adan2013/DIY-Arduino-Dashboard/graphics/faces/gauge faces v4 without controls.pdf

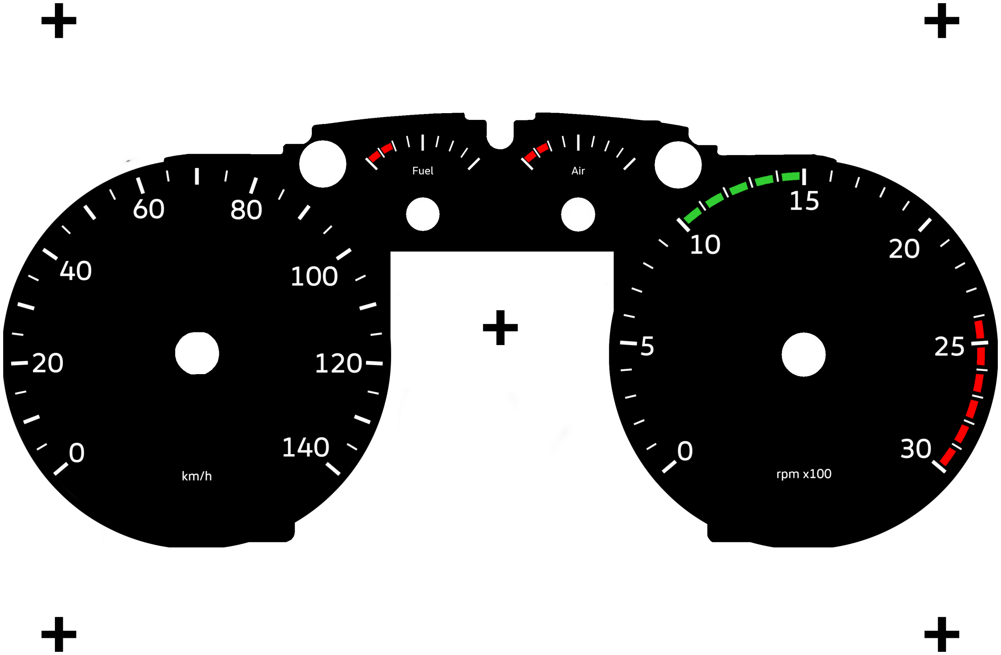
[picture p7: page 1]
