adan2013/DIY-Arduino-Dashboard/graphics/faces/gauge faces v4 with controls.pdf

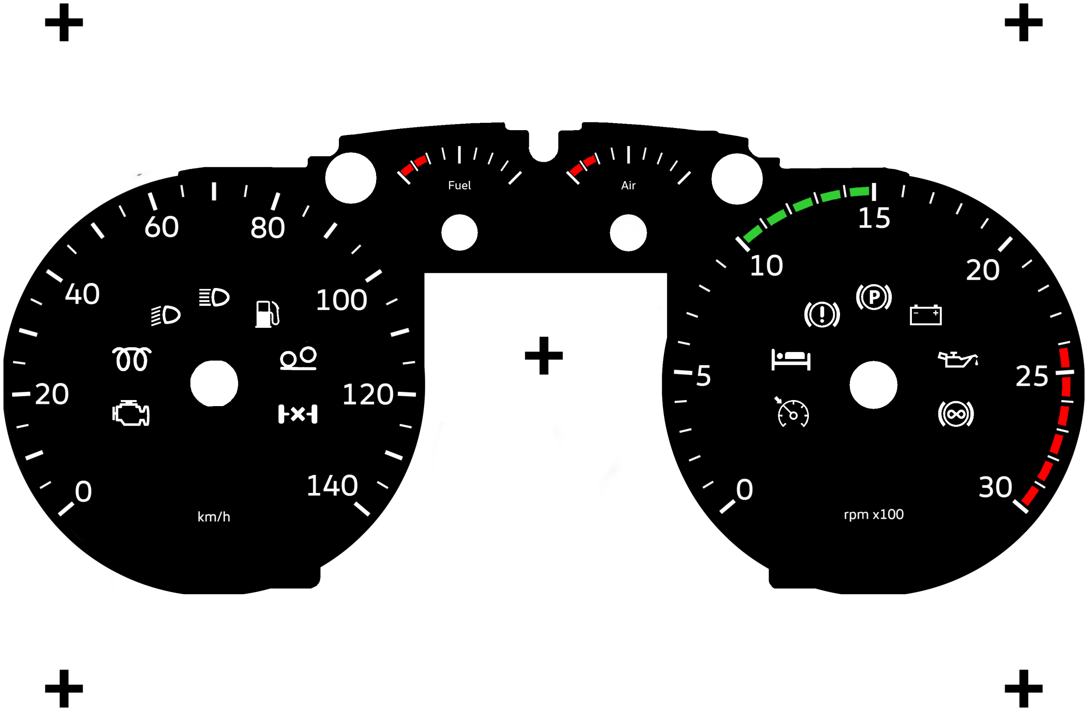
[picture p8: page 1]
