adan2013/DIY-Arduino-Dashboard/graphics/faces/gauge faces v3 bottom a4.pdf

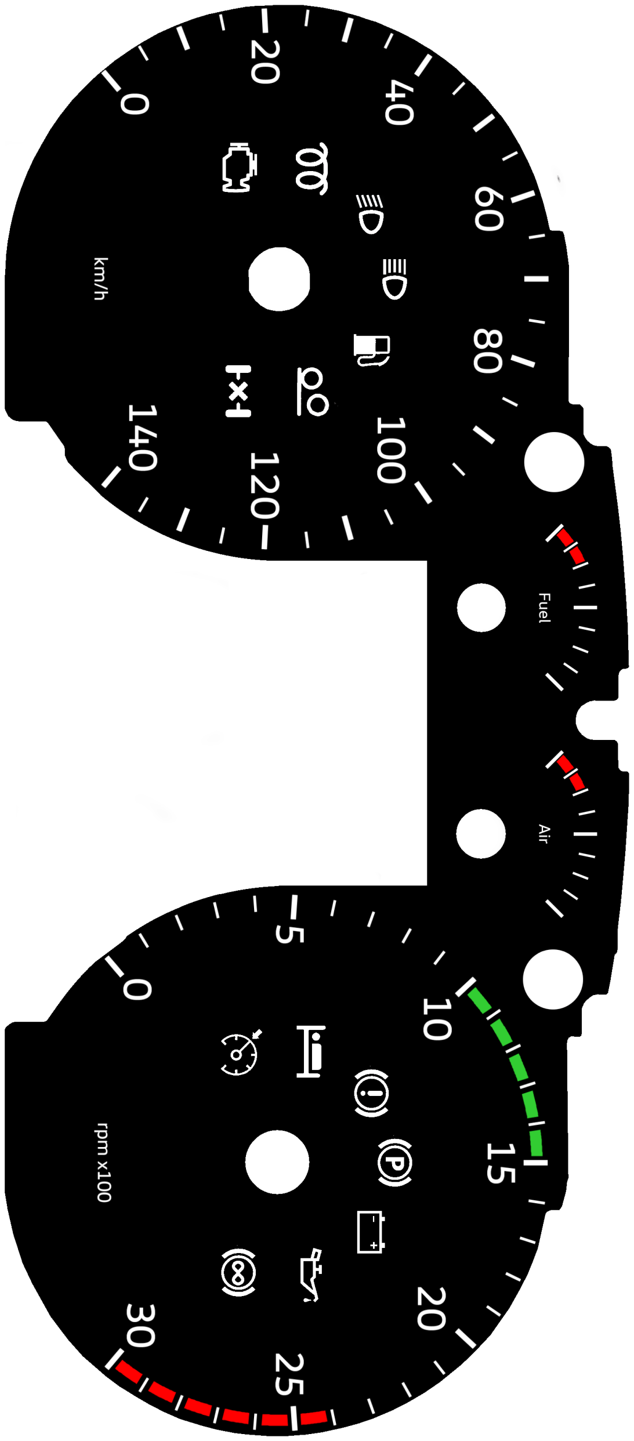
[picture p9: page 1]
