adan2013/DIY-Arduino-Dashboard/graphics/faces/gauge faces v3 top a4.pdf

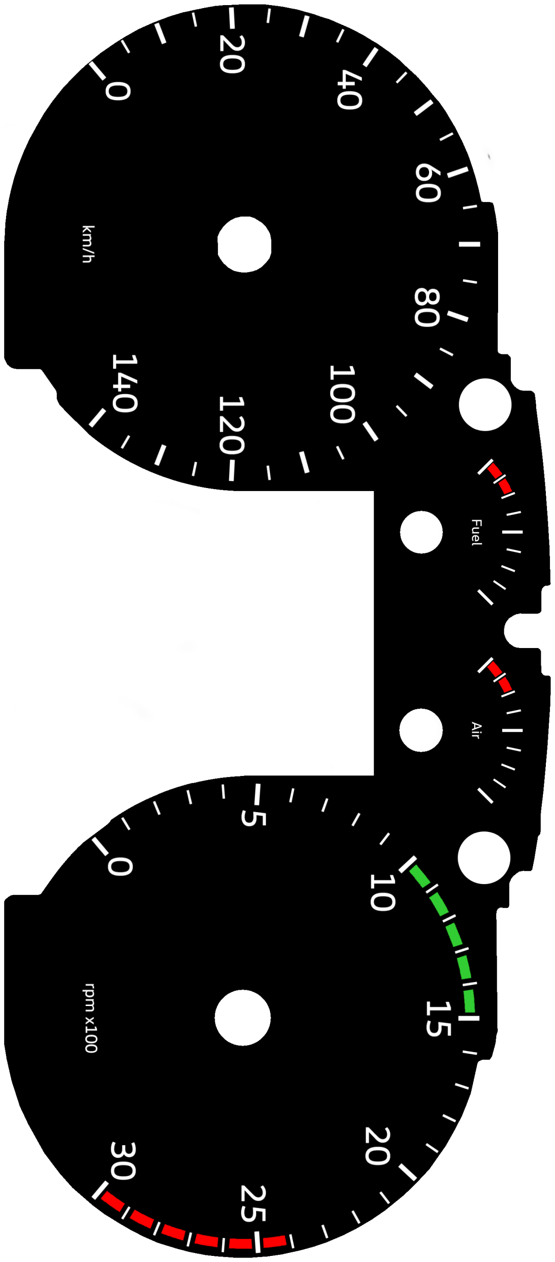
[picture p10: page 1]
