adan2013/DIY-Arduino-Dashboard/graphics/faces/gauge faces neg border a4.pdf

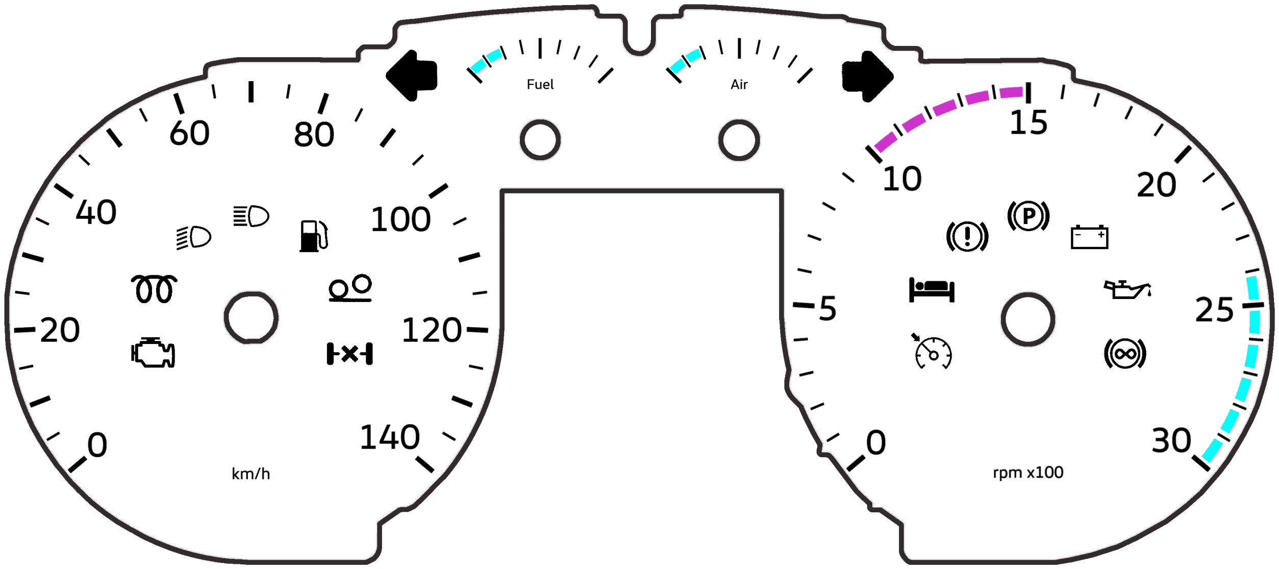
[picture p11: page 1]
