adan2013/DIY-Arduino-Dashboard/graphics/faces/gauge faces neg.png

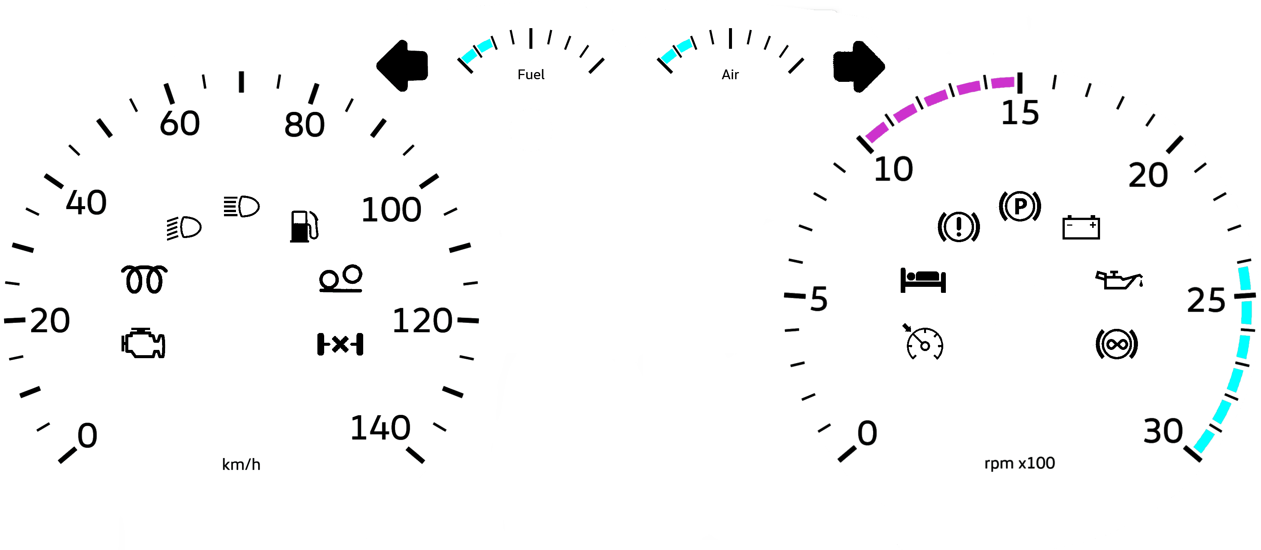
graphics/faces/gauge faces neg.png
