adan2013/DIY-Arduino-Dashboard/graphics/faces/gauge faces v2.png

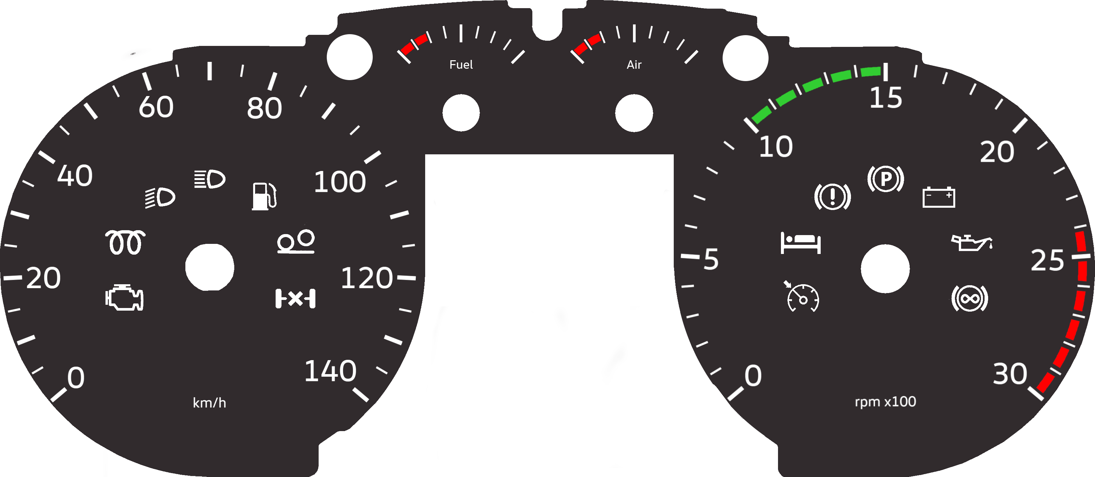
graphics/faces/gauge faces v2.png
