adan2013/DIY-Arduino-Dashboard/graphics/faces/original scan.jpg

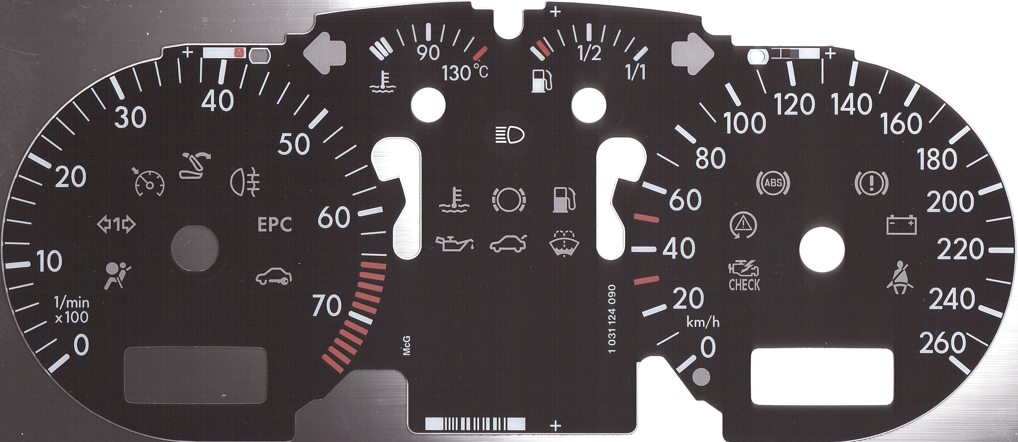
graphics/faces/original scan.jpg
