adan2013/DIY-Arduino-Dashboard/graphics/front/front.png

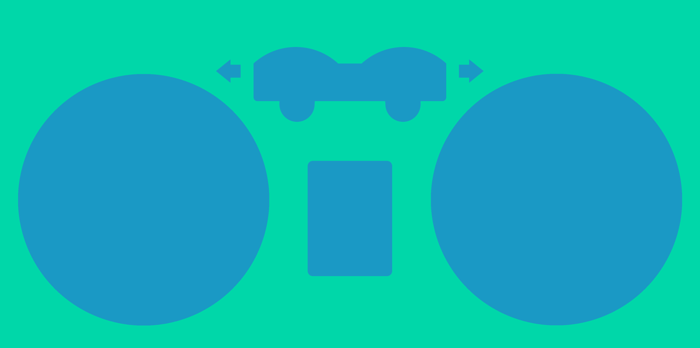
graphics/front/front.png
