adan2013/DIY-Arduino-Dashboard/graphics/front/original_scan.jpg

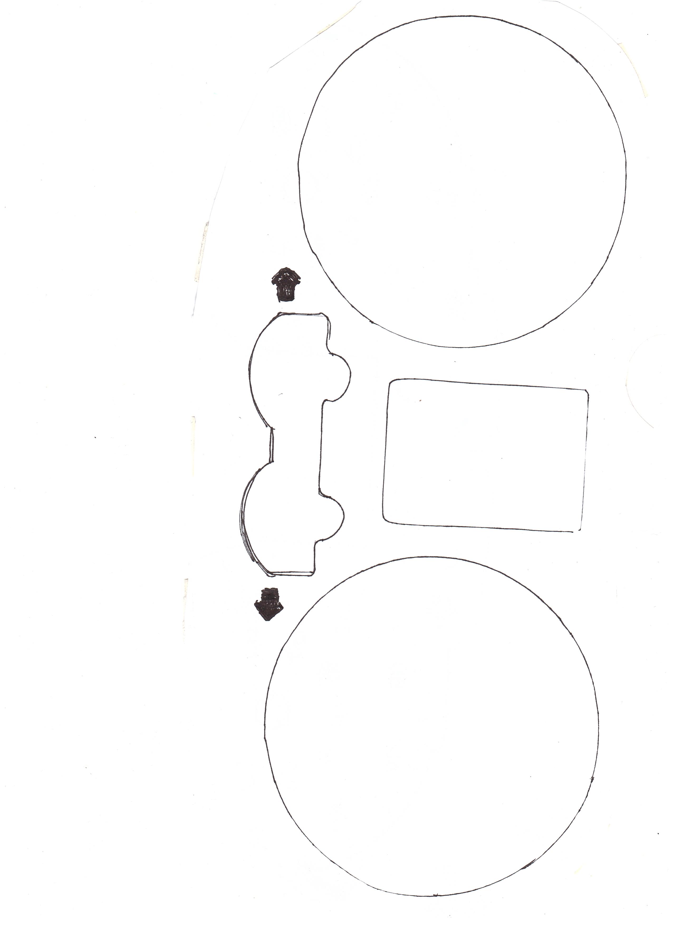
graphics/front/original_scan.jpg
