adan2013/DIY-Arduino-Dashboard/graphics/gauge generator projects/air.png

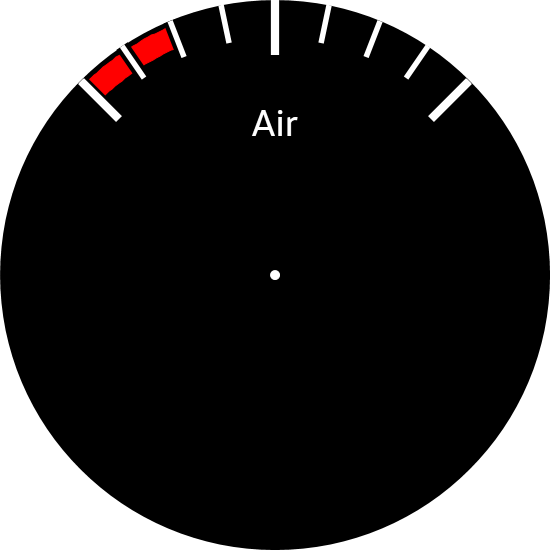
graphics/gauge generator projects/air.png
