adan2013/DIY-Arduino-Dashboard/graphics/gauge generator projects/engine.png

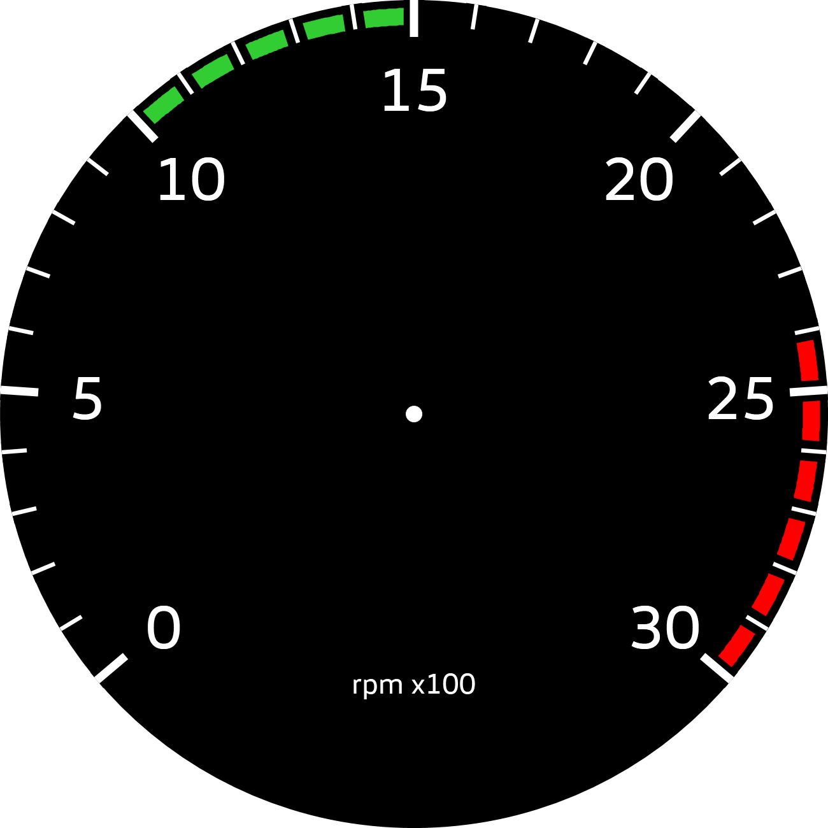
graphics/gauge generator projects/engine.png
