adan2013/DIY-Arduino-Dashboard/graphics/gauge generator projects/speed.png

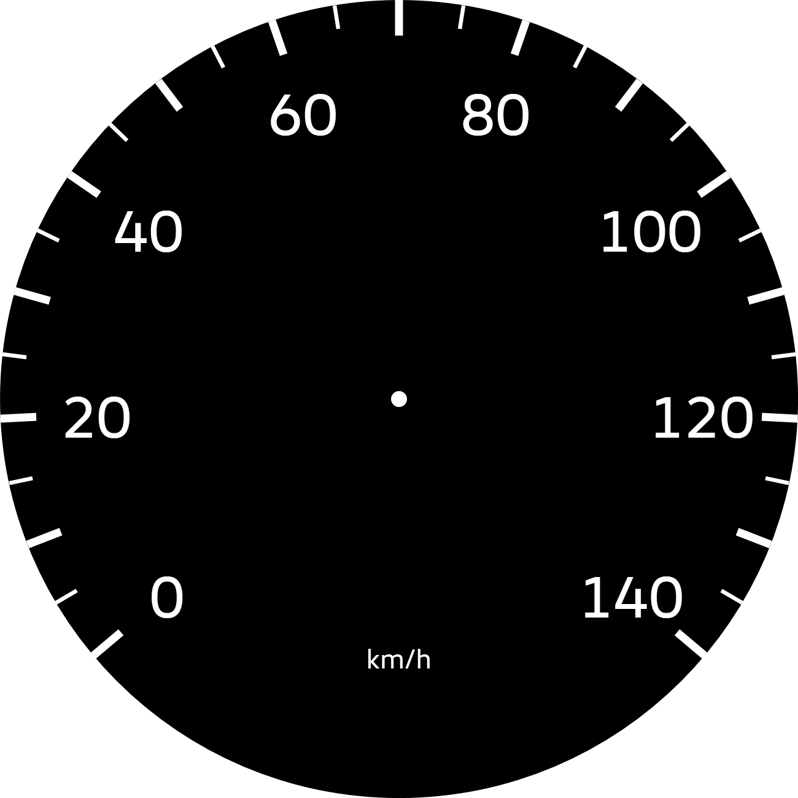
graphics/gauge generator projects/speed.png
