adan2013/DIY-Arduino-Dashboard/graphics/initial images/mercedes_big.jpg

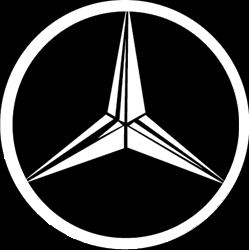
graphics/initial images/mercedes_big.jpg
