adan2013/DIY-Arduino-Dashboard/schema/arduino_schema.jpg

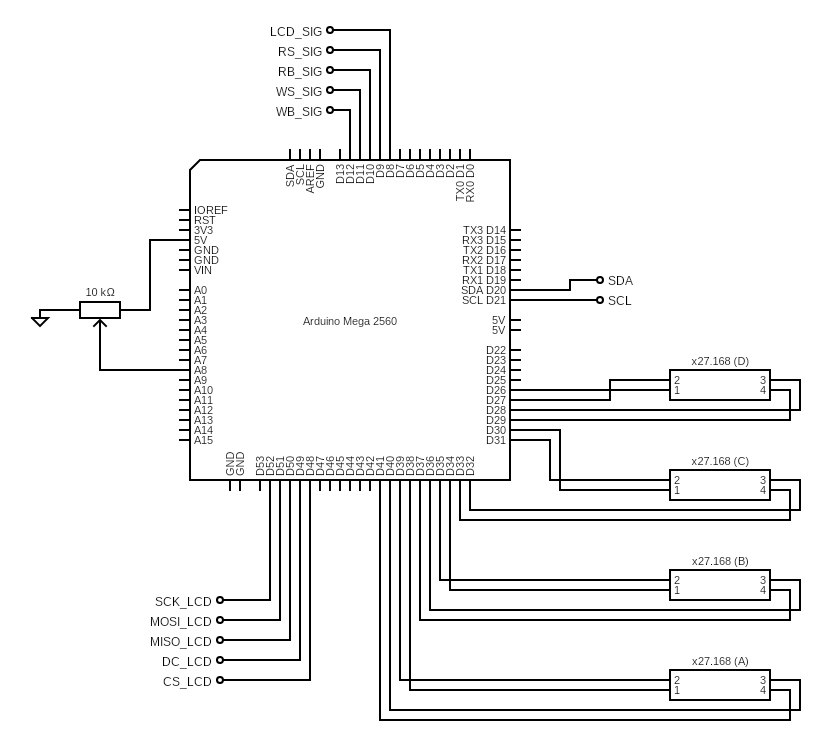
schema/arduino_schema.jpg
