adan2013/DIY-Arduino-Dashboard/schema/backlight_schema.jpg

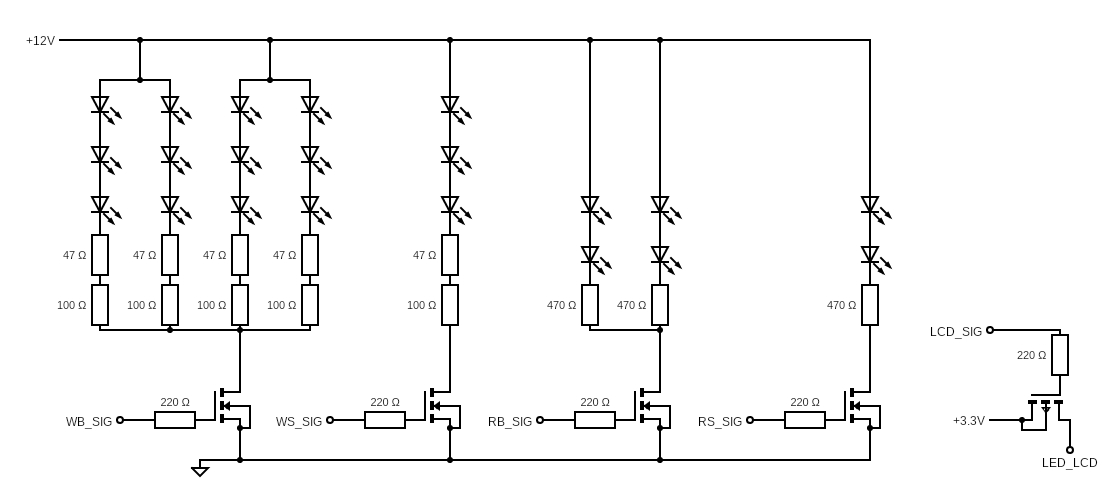
schema/backlight_schema.jpg
