adan2013/DIY-Arduino-Dashboard/schema/lcd_schema.jpg

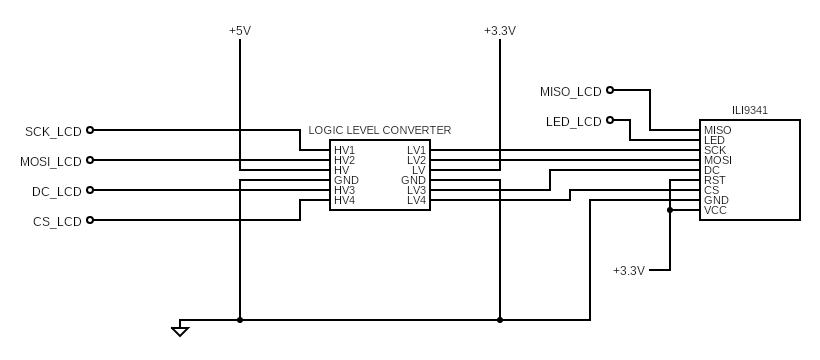
schema/lcd_schema.jpg
