adan2013/DIY-Arduino-Dashboard/schema/led_schema.jpg

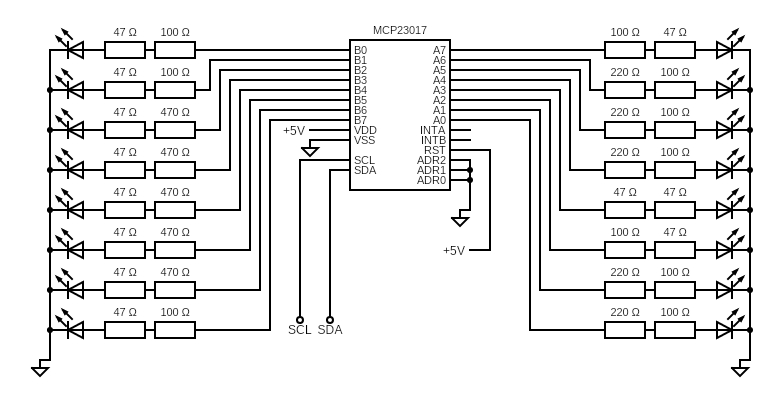
schema/led_schema.jpg
