adan2013/DIY-Arduino-Dashboard/graphics/front/front test v2.pdf

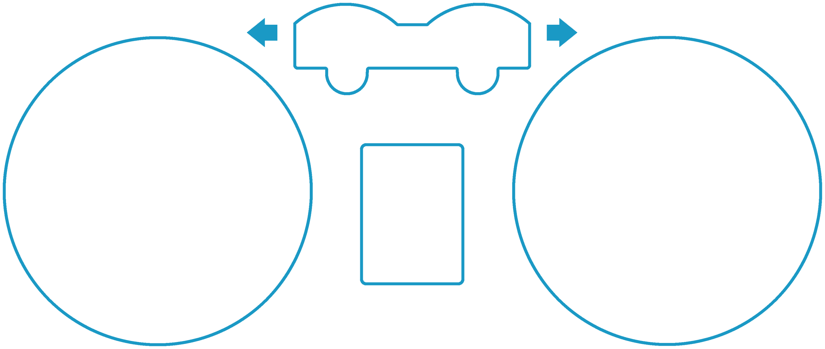
[picture p25: page 1]
