adan2013/DIY-Arduino-Dashboard/graphics/front/front test v1.pdf

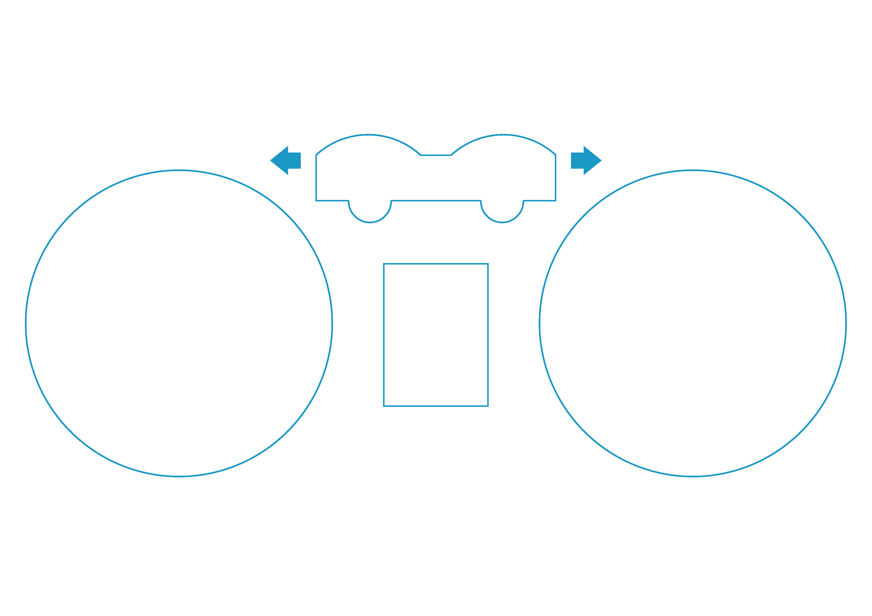
[picture p26: page 1]
