adan2013/DIY-Arduino-Dashboard/graphics/front/front test v1.png

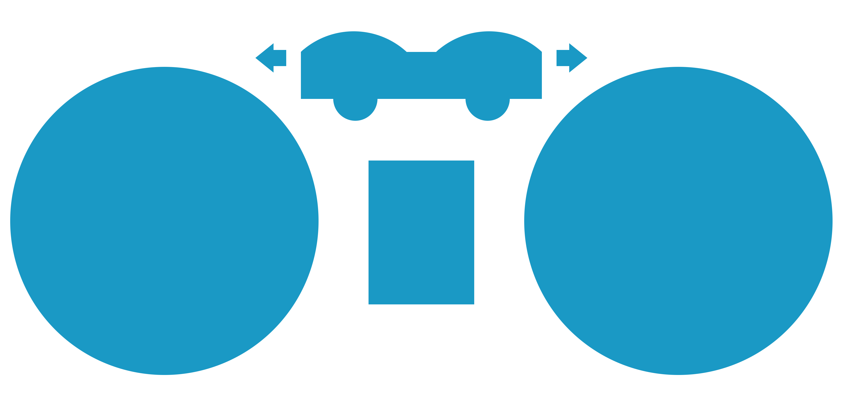
graphics/front/front test v1.png
