adan2013/DIY-Arduino-Dashboard/Arduino/ArduinoTelemetryReceiver/InitialImages.ino

// 'daf', 130x30px
const unsigned char dafImage [] PROGMEM = {
  0x00, 0x00, 0x00, 0x00, 0x00, 0x00, 0x00, 0x00, 0x00, 0x00, 0x00, 0x00, 0x00, 0x00, 0x00, 0x00, 
  0x00, 0x00, 0x00, 0x00, 0x00, 0x00, 0x00, 0x00, 0x00, 0x00, 0x00, 0x00, 0x00, 0x00, 0x00, 0x00, 
  0x00, 0x00, 0x00, 0x00, 0x00, 0x00, 0x00, 0x00, 0x00, 0x00, 0x00, 0x00, 0x00, 0x00, 0x00, 0x00, 
  0x00, 0x00, 0x00, 0xff, 0xff, 0xff, 0xfc, 0x00, 0x00, 0x03, 0xff, 0xff, 0xe0, 0x00, 0x1f, 0xff, 
  0xff, 0xff, 0xff, 0xc0, 0xff, 0xff, 0xff, 0xff, 0xc0, 0x00, 0x07, 0xff, 0xff, 0xf0, 0x00, 0x1f, 
  0xff, 0xff, 0xff, 0xff, 0xc0, 0xff, 0xff, 0xff, 0xff, 0xf0, 0x00, 0x07, 0xff, 0xff, 0xf8, 0x00, 
  0x1f, 0xff, 0xff, 0xff, 0xff, 0xc0, 0xff, 0xff, 0xff, 0xff, 0xfc, 0x00, 0x0f, 0xff, 0xff, 0xf8, 
  0x00, 0x1f, 0xff, 0xff, 0xff, 0xff, 0xc0, 0xff, 0xff, 0xff, 0xff, 0xfe, 0x00, 0x1f, 0xff, 0xff, 
  0xfc, 0x00, 0x1f, 0xff, 0xff, 0xff, 0xff, 0xc0, 0xff, 0xff, 0xff, 0xff, 0xff, 0x00, 0x1f, 0xff, 
  0xff, 0xfe, 0x00, 0x1f, 0xff, 0xff, 0xff, 0xff, 0xc0, 0xff, 0xff, 0xff, 0xff, 0xff, 0x00, 0x3f, 
  0xff, 0xff, 0xfe, 0x00, 0x1f, 0xff, 0xff, 0xff, 0xff, 0xc0, 0xff, 0xfe, 0x01, 0xff, 0xff, 0x80, 
  0x3f, 0xff, 0xff, 0xff, 0x00, 0x1f, 0xff, 0xe0, 0x00, 0x00, 0x00, 0xff, 0xfe, 0x00, 0x7f, 0xff, 
  0x80, 0x7f, 0xff, 0x3f, 0xff, 0x00, 0x1f, 0xff, 0xe0, 0x00, 0x00, 0x00, 0xff, 0xfe, 0x00, 0x3f, 
  0xff, 0xc0, 0x7f, 0xff, 0x3f, 0xff, 0x80, 0x1f, 0xff, 0xe0, 0x00, 0x00, 0x00, 0xff, 0xfe, 0x00, 
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
  0xff, 0xff, 0xff, 0xc0, 0xff, 0xff, 0xff, 0xff, 0xff, 0xff, 0xff, 0xff, 0xff, 0xff, 0xff, 0xc0, 
  0xff, 0xff, 0xff, 0xff, 0xff, 0xff, 0xff, 0xff, 0xff, 0xff, 0xff, 0xc0, 0x7f, 0xf8, 0x00, 0x00, 
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
};
