adan2013/DIY-Arduino-Dashboard/tests/led_backlight_controller_test/led_backlight_controller_test.ino

#include <Wire.h>
#include <Adafruit_MCP23017.h>

Adafruit_MCP23017 mcp;

void setup() {
  //LED
  mcp.begin();
  for(int i = 0; i < 16; i++) {
    mcp.pinMode(i, OUTPUT);
    mcp.digitalWrite(i, LOW);
  }
  //BACKLIGHT
  pinMode(8, OUTPUT);
  pinMode(9, OUTPUT);
  pinMode(10, OUTPUT);
  pinMode(11, OUTPUT);
  digitalWrite(8, LOW);
  digitalWrite(9, LOW);
  digitalWrite(10, LOW);
  digitalWrite(11, LOW);
}

void loop() {
  for(int i = 0; i < 16; i++) {
    //LED
    int prev = i - 1;
    if(prev < 0) prev = 15;
    mcp.digitalWrite(prev, LOW);
    mcp.digitalWrite(i, HIGH);
    //BACKLIGHT
    switch(i) {
      case 0:
      case 1:
      case 2:
        digitalWrite(8, HIGH);
        digitalWrite(9, LOW);
        digitalWrite(10, LOW);
        digitalWrite(11, LOW);
        break;
      case 3:
      case 4:
      case 5:
        digitalWrite(8, HIGH);
        digitalWrite(9, HIGH);
        digitalWrite(10, LOW);
        digitalWrite(11, LOW);
        break;
      case 6:
      case 7:
      case 8:
        digitalWrite(8, HIGH);
        digitalWrite(9, HIGH);
        digitalWrite(10, HIGH);
        digitalWrite(11, LOW);
        break;
      case 9:
      case 10:
      case 11:
      case 12:
        digitalWrite(8, HIGH);
        digitalWrite(9, HIGH);
        digitalWrite(10, HIGH);
        digitalWrite(11, HIGH);
        break;
      case 13:
      case 14:
      case 15:
        digitalWrite(8, LOW);
        digitalWrite(9, LOW);
        digitalWrite(10, LOW);
        digitalWrite(11, LOW);
        break;
    }
    delay(500);
  }
}
