adan2013/DIY-Arduino-Dashboard/(commit log)

2020-04-22 mcp test & i2c scan
2020-06-08 led controller test code
2020-06-16 backlight pwm test code
2020-07-06 new screen & sound control buttons
2020-07-11 first version of arduino code
2020-07-21 final front 4mm version
2020-12-30 lcd test with hardware spi
2021-01-01 motor control improvements WIP
2021-01-01 arduino serial reader - first version
2021-01-03 hardware blinking leds
2021-01-04 trailer screen v2 fix
    [ScreenPrint.ino, ScreenUpdate.ino]
2021-01-05 MOTOR_LATENCY deleted
2021-01-12 welcome signal & led animation
2021-02-13 sound and notification fix
    [ScreenTools.ino]
2021-02-14 final fixs, deleted current speed from assistant fields, refresh data optimization
    [ScreenTools.ino, ScreenUpdate.ino]
2021-02-14 final fixs, deleted current speed from assistant fields, deleted trailer name, refresh data optimizationg
    [ScreenTools.ino, ScreenUpdate.ino]
2021-04-23 gauge max value calibration
